alkyl1978/mishen_cxema/README.md

Схемы и прошивки основного блока и ракеток мишени
