alkyl1978/mishen_cxema/сумматор/mishen.jpg

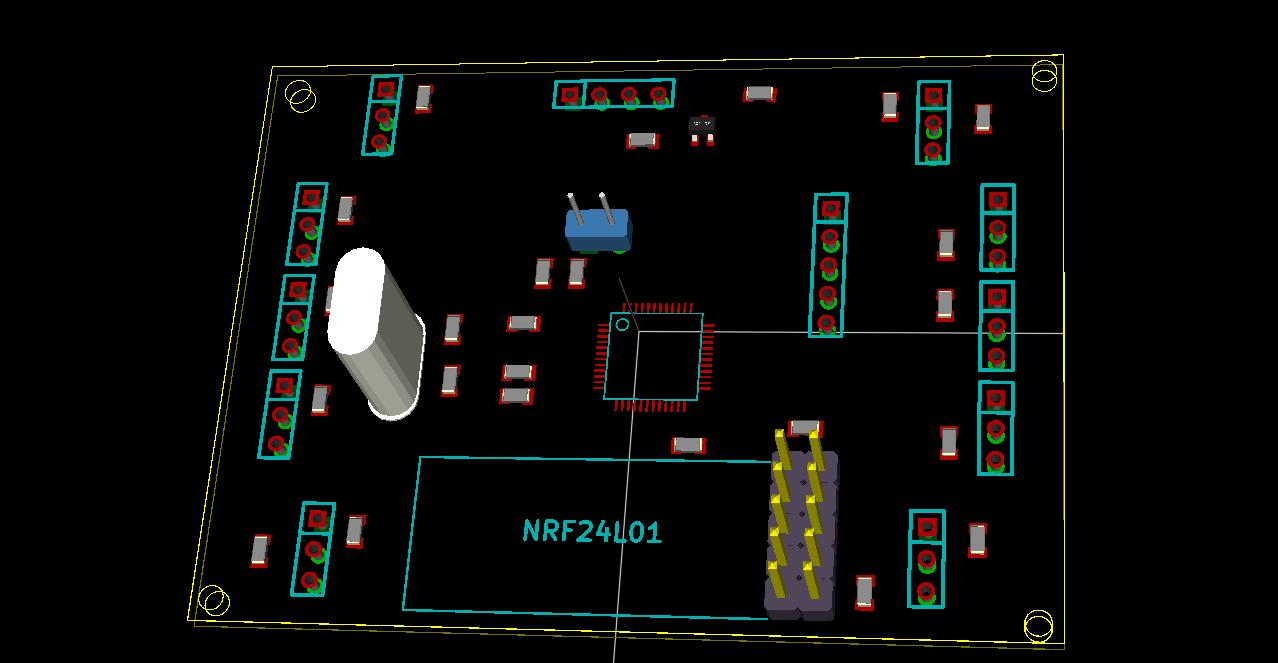
сумматор/mishen.jpg
