alkyl1978/mishen_cxema/(list of files, cad)

Other CAD files:
схемы /Мишень и ракетки ПО/Surnmo_r/Surnmo_r.obj
