alkyl1978/mishen_cxema/схемы /Монитор и клавиатура.pdf

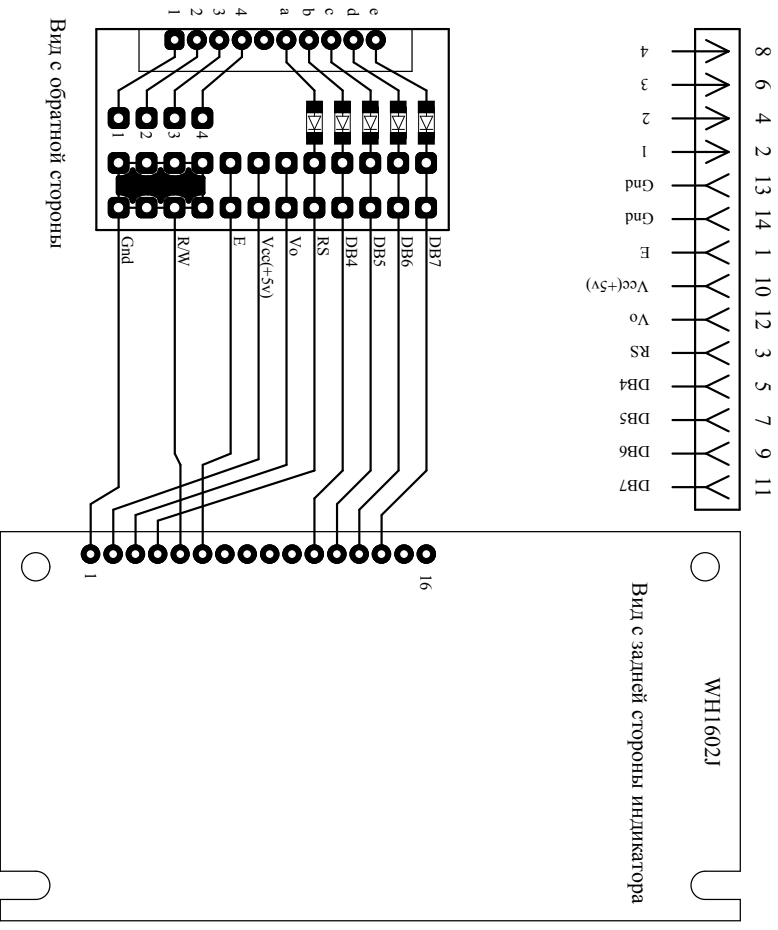
[picture p7: page 1]
Gnd; Vcc(+5v)

Вид с обратной стороны

Вид с задней стороны индикатора
