alkyl1978/mishen_cxema/схемы /Расположение элементов.pdf

SS3

SS2

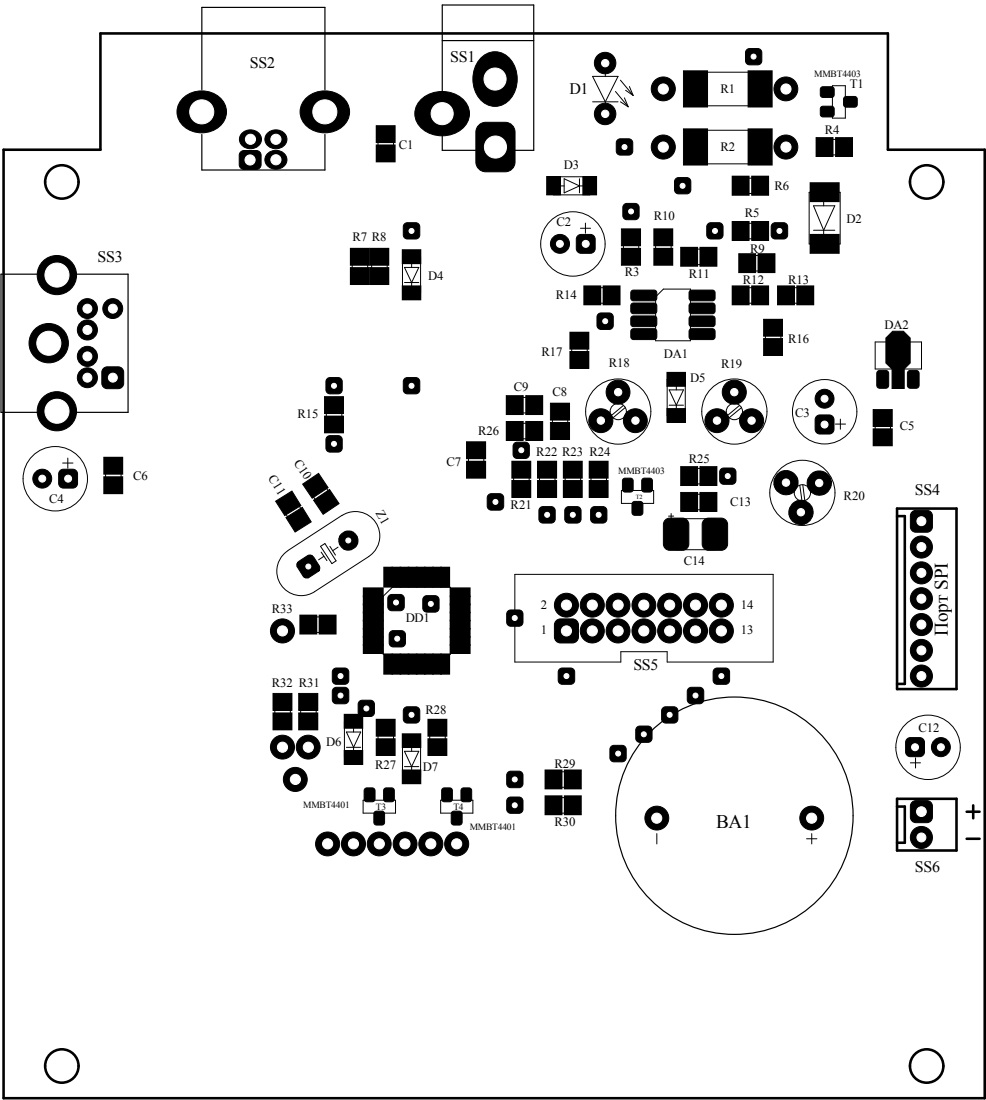
[picture p8: page 1]
