alkyl1978/mishen_cxema/схемы /Схема  инд. и клав.pdf

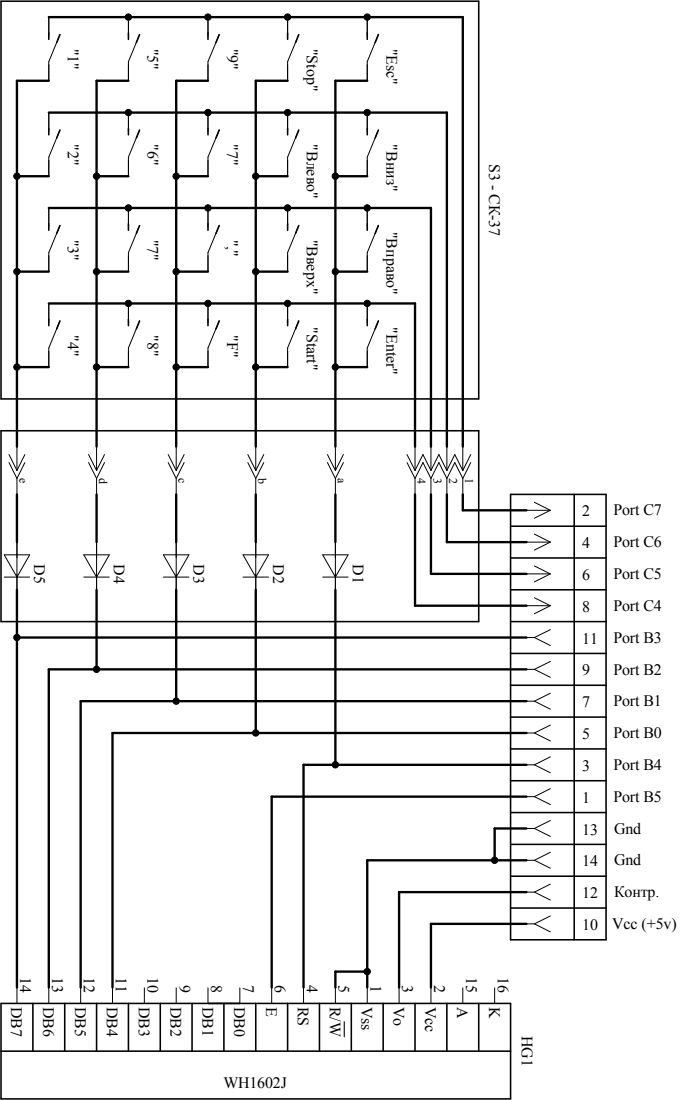
[picture p9: page 1]
