alkyl1978/mishen_cxema/схемы /Схема процессорной платы.pdf

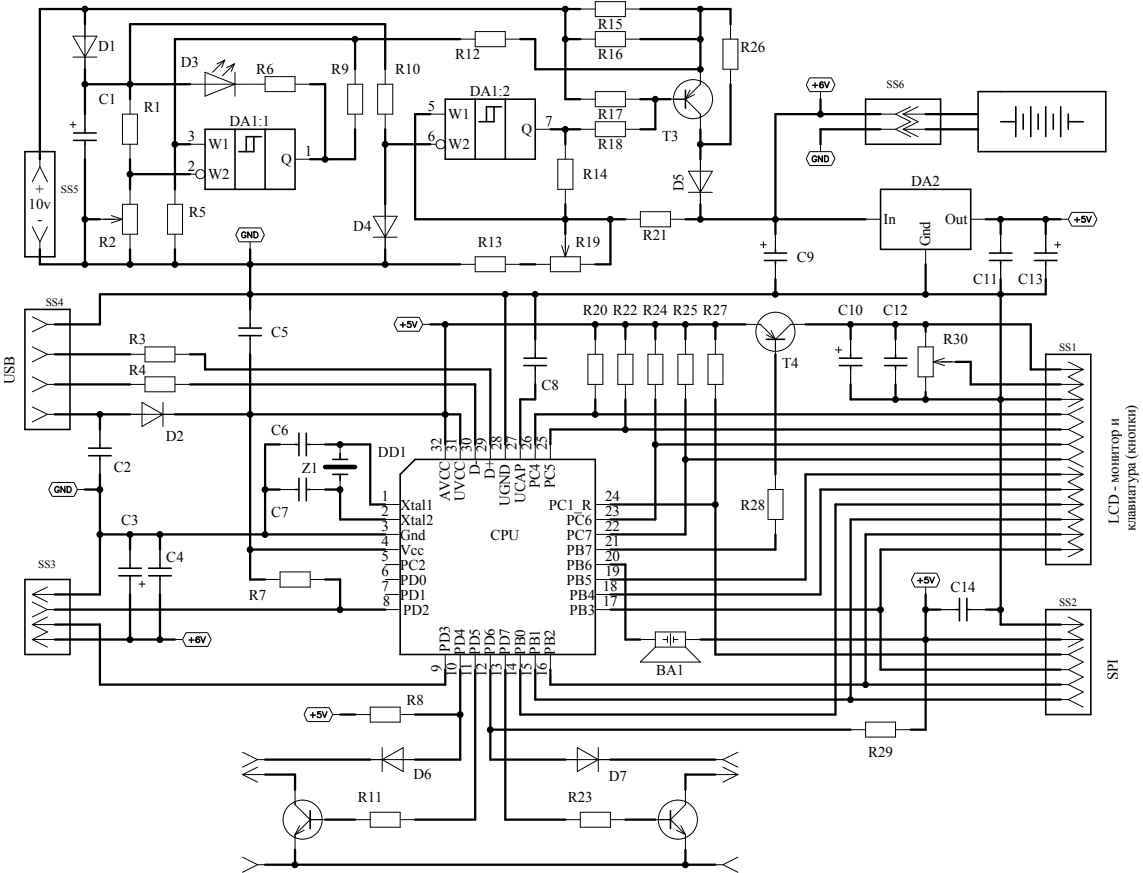
[picture p10: page 1]
