alkyl1978/mishen_cxema/сумматор/mishen.pdf

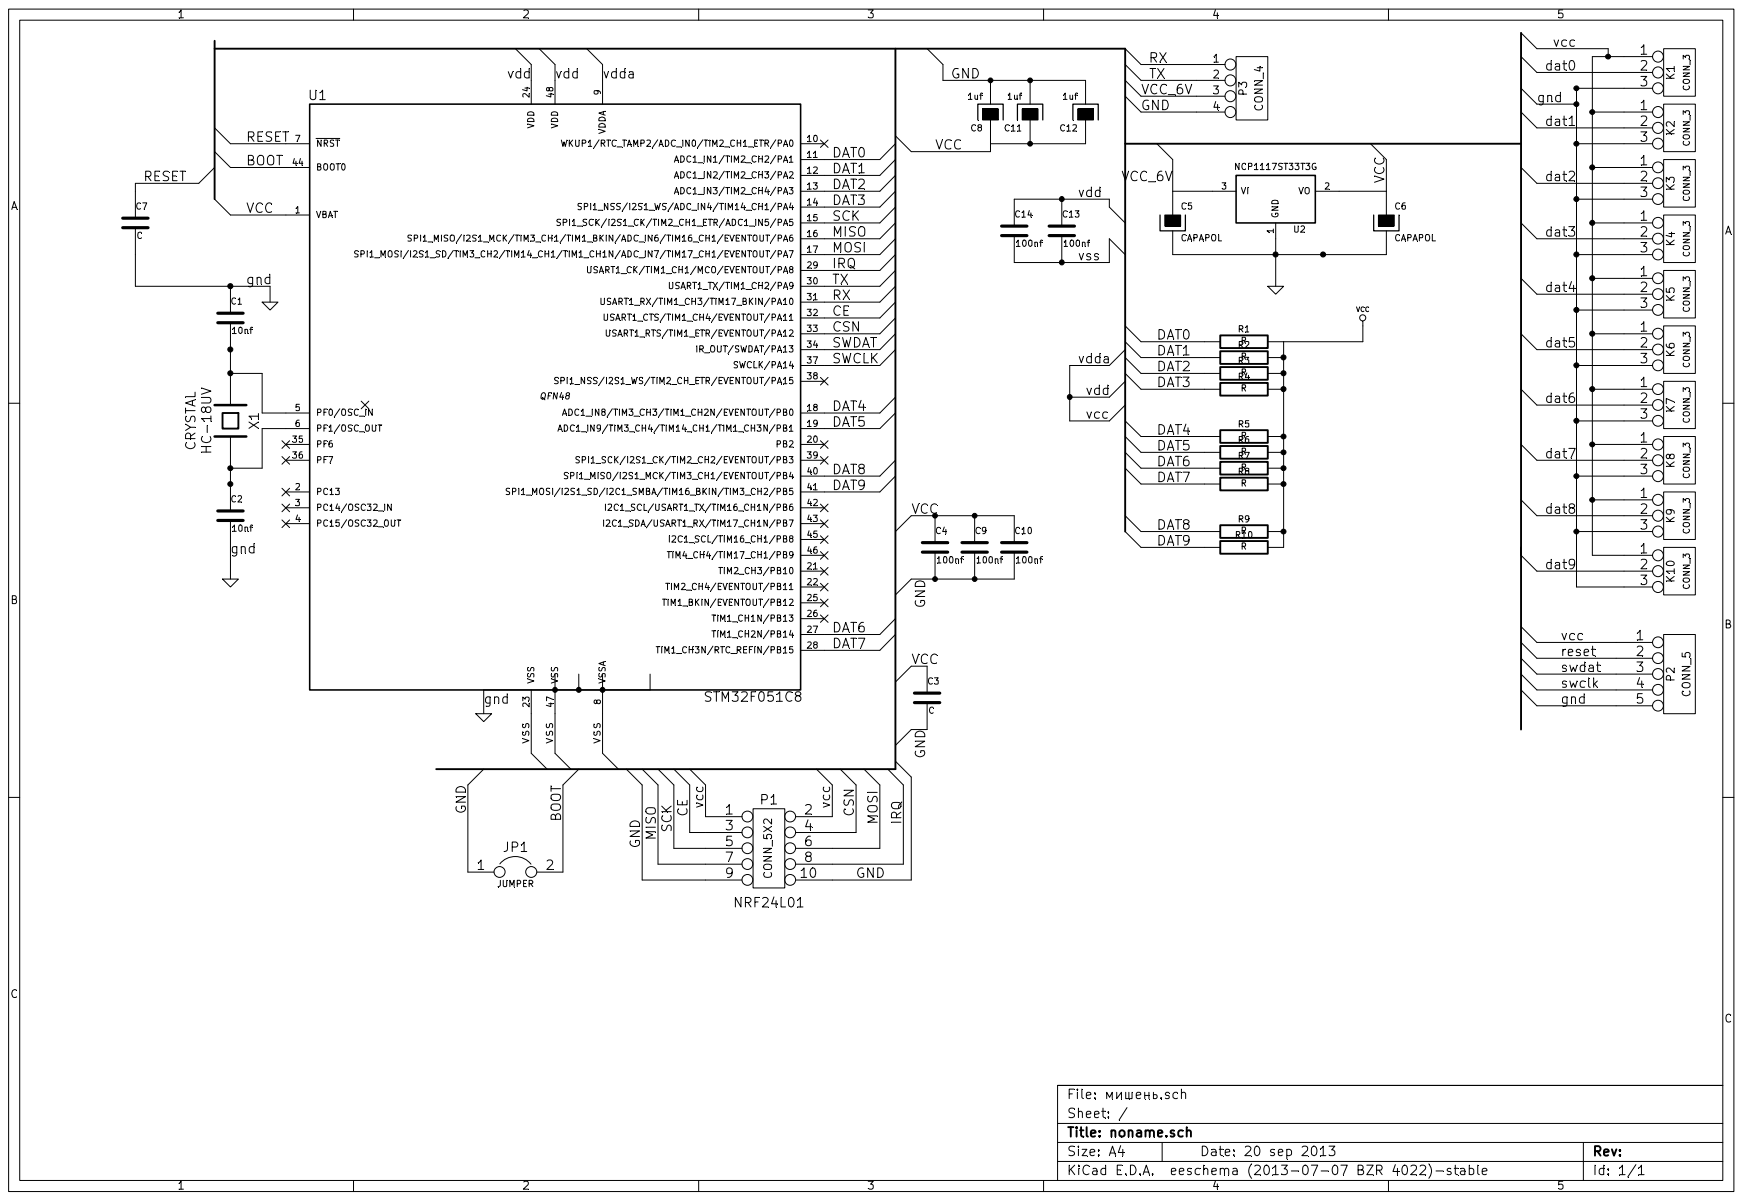
[picture p11: page 1]
