alkyl1978/mishen_cxema/(list of files, drawings)

Other design files:
доработки/cvoe_detektor/detektor.DSN
доработки/cvoe_raketka_a/nrf24l01.DSN
доработки/cvoe_raketka_a/Racket_ATtiny24.PCB
доработки/cvoe_raketka_a/raketka.DSN
доработки/cvoe_raketka_b/nrf24l01.DSN
доработки/cvoe_raketka_b/Racket_ATtiny24.PCB
доработки/cvoe_raketka_b/raketka.DSN
доработки/cvoe_summator/summator.DSN
сумматор/mishen.dsn
схемы /Датчик/Датчик .PCB
схемы /Мишень/Платы/Инд. и клав.PCB
схемы /Мишень/Платы/Плата, инд. и клав.PCB
схемы /Мишень/Платы/Процессорная плата.PCB
схемы /Мишень/Платы/Сумматор.pcb
схемы /Ракетка/Detector_ATtiny2313S.PCB
схемы /Ракетка/Racket_ATtiny24.PCB
