alkyl1978/mishen_cxema/сумматор/mishen.kicad_pcb

## KiCad design сумматор/mishen.kicad_pcb (2015-11-22)

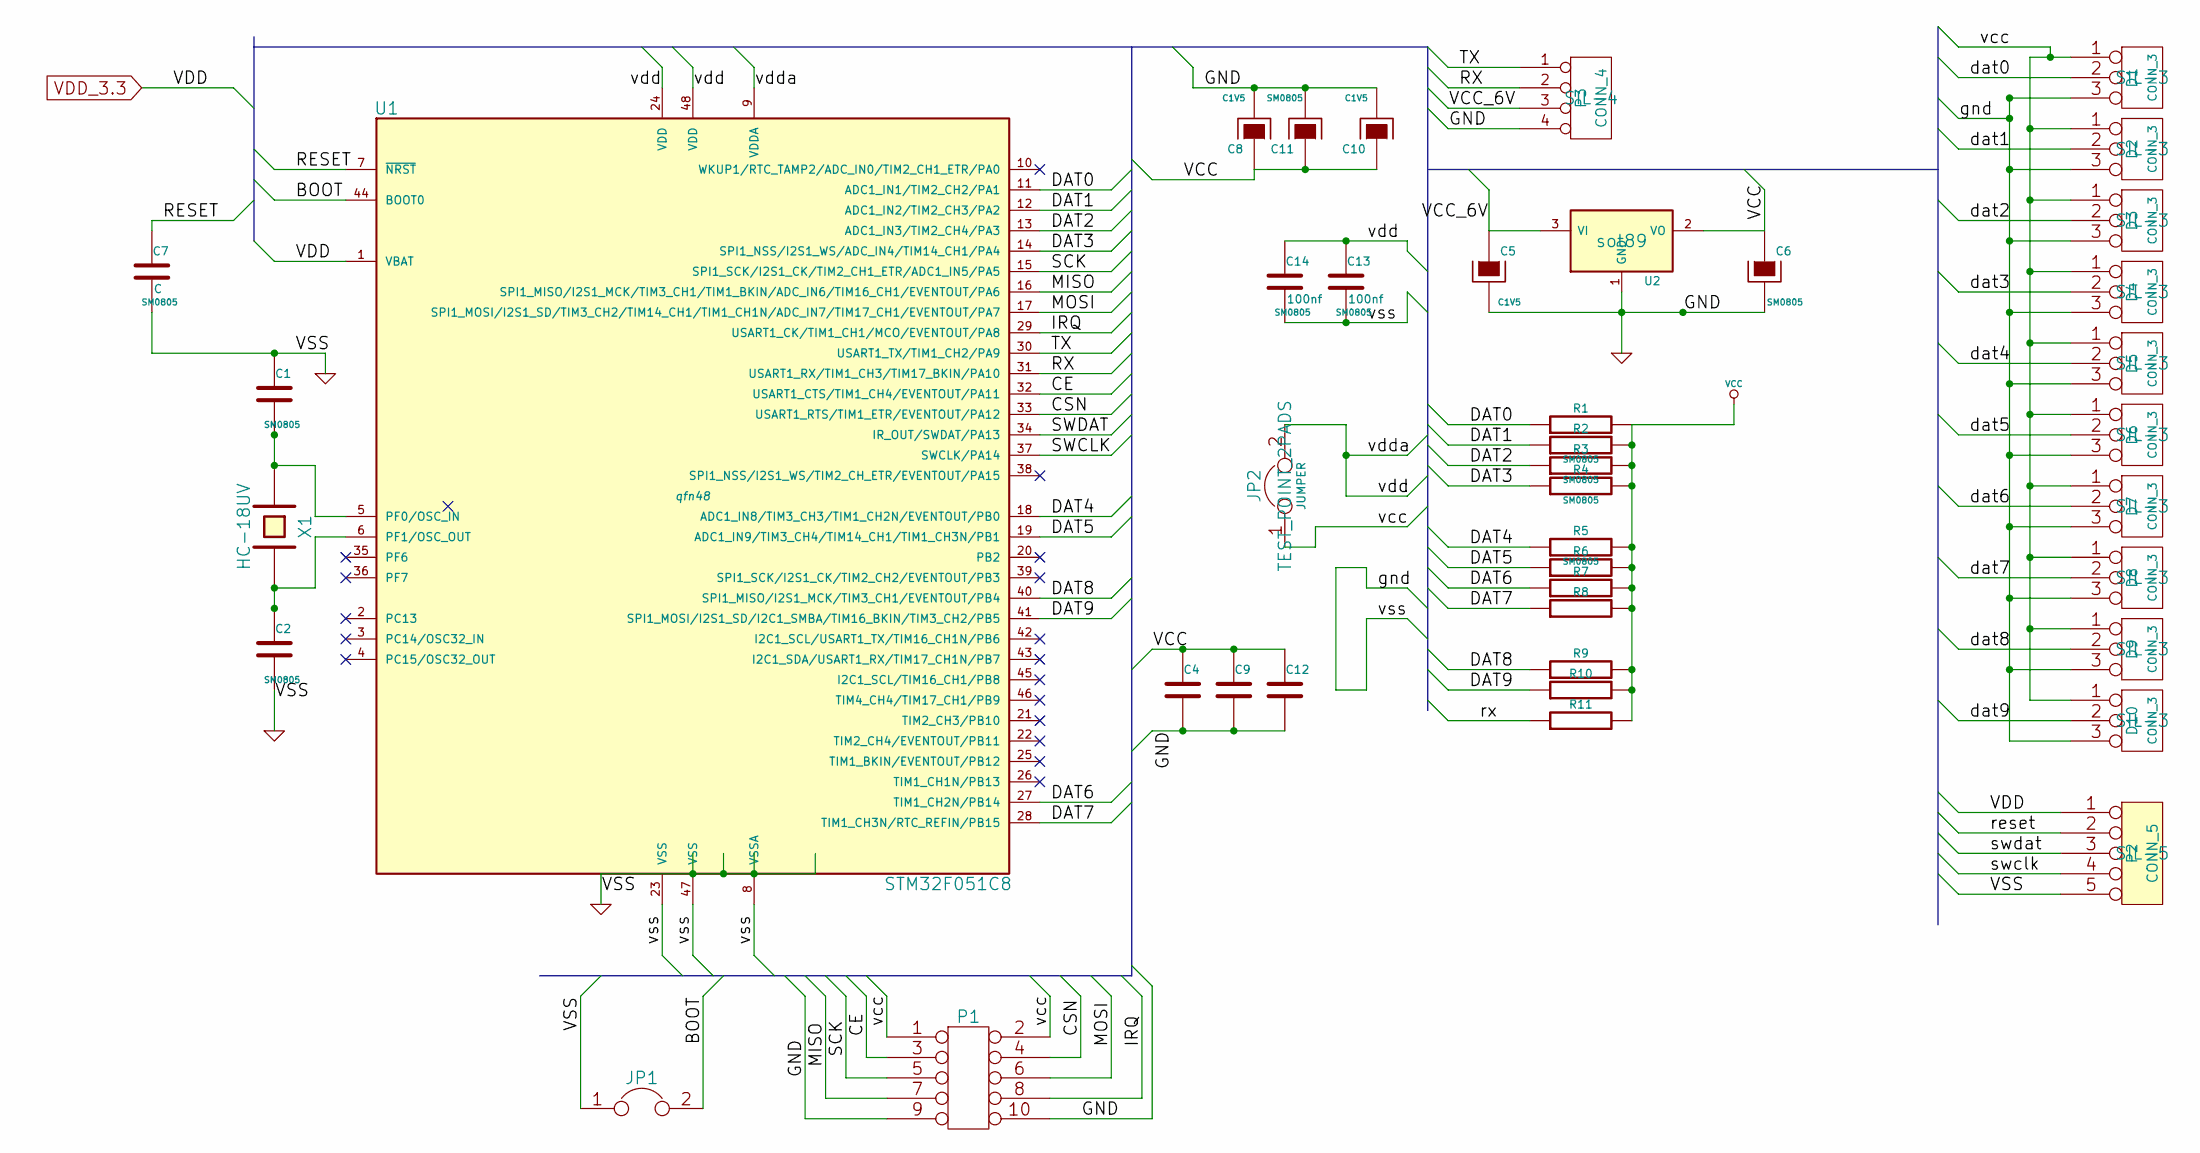
[picture p12: schematic mishen.sch, noname.sch]

Parts:
C1, C2: 10nf; SM0805
C4, C9, C12, C13, C14: 100nf; SM0805
C5: CAPAPOL; C1V5
C6: CAPAPOL; SM0805
C7: C; SM0805
C8, C10: 1uf; C1V5
C11: 1uf; SM0805
D1, D2, D3, D4, D5, D6, D7, D8, D9, D10: CONN_3; SIL-3
JP1, JP2: JUMPER; TEST_POINT_2PADS
P1: CONN_5X2; PIN_ARRAY_5x2
P2: CONN_5; SIL-5
P3: CONN_4; SIL-4
R1: 1KOM; SM0805
R2, R3, R4, R5, R6, R7, R8, R9, R10, R11: R; SM0805
U1: STM32F051С8; qfn48
U2: NCP1117ST33T3G; sot89
X1: 16MGZ; HC-18UV

Connections:
/BOOT: JP1.2, U1.44 (BOOT0)
/CE: P1.3, U1.32 (USART1_CTS/TIM1_CH4/EVENTOUT/PA11)
/CSN: P1.4, U1.33 (USART1_RTS/TIM1_ETR/EVENTOUT/PA12)
/DAT0: D1.2 (PM), R1.1, U1.11 (ADC1_IN1/TIM2_CH2/PA1)
/DAT1: D2.2 (PM), R2.1, U1.12 (ADC1_IN2/TIM2_CH3/PA2)
/DAT2: D3.2 (PM), R3.1, U1.13 (ADC1_IN3/TIM2_CH4/PA3)
/DAT3: D4.2 (PM), R4.1, U1.14 (SPI1_NSS/I2S1_WS/ADC_IN4/TIM14_CH1/PA4)
/DAT4: D5.2 (PM), R5.1, U1.18 (ADC1_IN8/TIM3_CH3/TIM1_CH2N/EVENTOUT/PB0)
/DAT5: D6.2 (PM), R6.1, U1.19 (ADC1_IN9/TIM3_CH4/TIM14_CH1/TIM1_CH3N/P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)
/DAT6: D7.2 (PM), R7.1, U1.27 (TIM1_CH2N/PB14)
/DAT7: D8.2 (PM), R8.1, U1.28 (TIM1_CH3N/RTC_REFIN/PB15)
/DAT8: D9.2 (PM), R9.1, U1.40 (SPI1_MISO/I2S1_MCK/TIM3_CH1/EVENTOUT/PB4)
/DAT9: D10.2 (PM), R10.1, U1.41 (SPI1_MOSI/I2S1_SD/I2C1_SMBA/TIM16_BKIN/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)
/IRQ: P1.8, U1.29 (USART1_CK/TIM1_CH1/MCO/EVENTOUT/PA8)
/MISO: P1.7, U1.16 (SPI1_MISO/I2S1_MCK/TIM3_CH1/TIM1_BKIN/A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)
/MOSI: P1.6, U1.17 (SPI1_MOSI/I2S1_SD/TIM3_CH2/TIM14_CH1/TI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)
/RESET: C7.1, P2.2, U1.7 (~NRST)
/RX: P3.2, R11.1, U1.31 (USART1_RX/TIM1_CH3/TIM17_BKIN/PA10)
/SCK: P1.5, U1.15 (SPI1_SCK/I2S1_CK/TIM2_CH1_ETR/ADC1_IN5/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)
/SWCLK: P2.4, U1.37 (SWCLK/PA14)
/SWDAT: P2.3, U1.34 (IR_OUT/SWDAT/PA13)
/TX: P3.1, U1.30 (USART1_TX/TIM1_CH2/PA9)
/VCC_6V: C5.1, P3.3, U2.3 (VI)
GND: C1.1, C2.2, C4.2, C5.2, C6.2, C7.2, C8.2, C9.2, C10.2, C11.2, C12.2, C13.2, C14.2, D1.3, D2.3, D3.3, D4.3, D5.3, D6.3, D7.3, D8.3, D9.3, D10.3, JP1.1, P1.9, P1.10, P2.5, P3.4, U1.8 (VSSA), U1.23 (VSS), U1.47 (VSS), U2.1 (GND)
unnamed: C2.1, U1.6 (PF1/OSC_OUT), X1.2
unnamed: C1.2, U1.5 (PF0/OSC_IN), X1.1
VCC: C4.1, C6.1, C8.1, C9.1, C10.1, C11.1, C12.1, D1.1, D2.1, D3.1, D4.1, D5.1, D6.1, D7.1, D8.1, D9.1, D10.1, JP2.1, P1.1, P1.2, R1.2, R2.2, R3.2, R4.2, R5.2, R6.2, R7.2, R8.2, R9.2, R10.2, R11.2, U2.2 (VO)
VDD_3.3: C13.1, C14.1, JP2.2, P2.1, U1.1 (VBAT), U1.9 (VDDA), U1.24 (VDD), U1.48 (VDD)

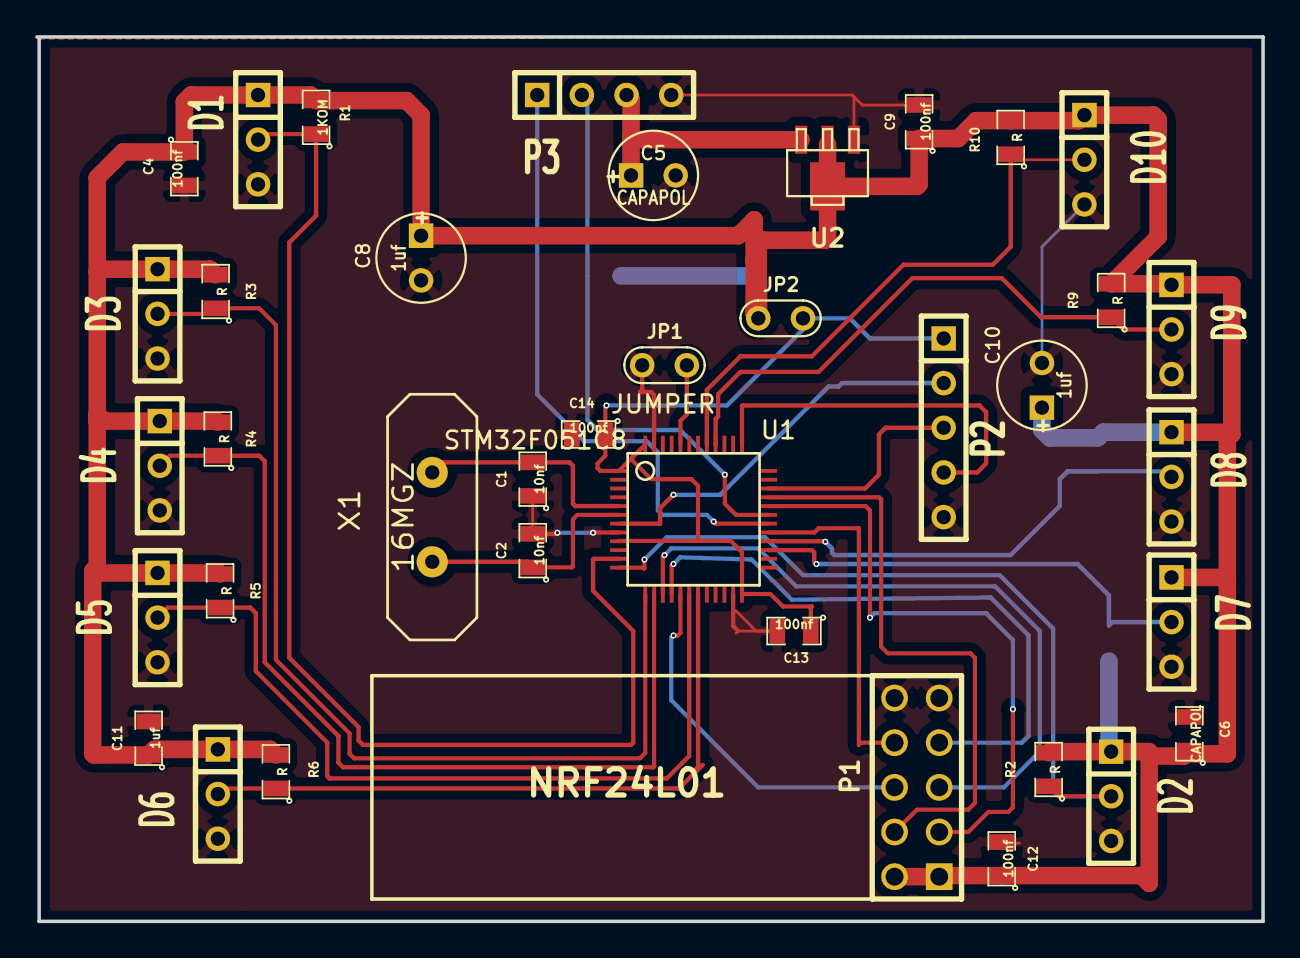
[picture p13: board mishen.kicad_pcb from above]

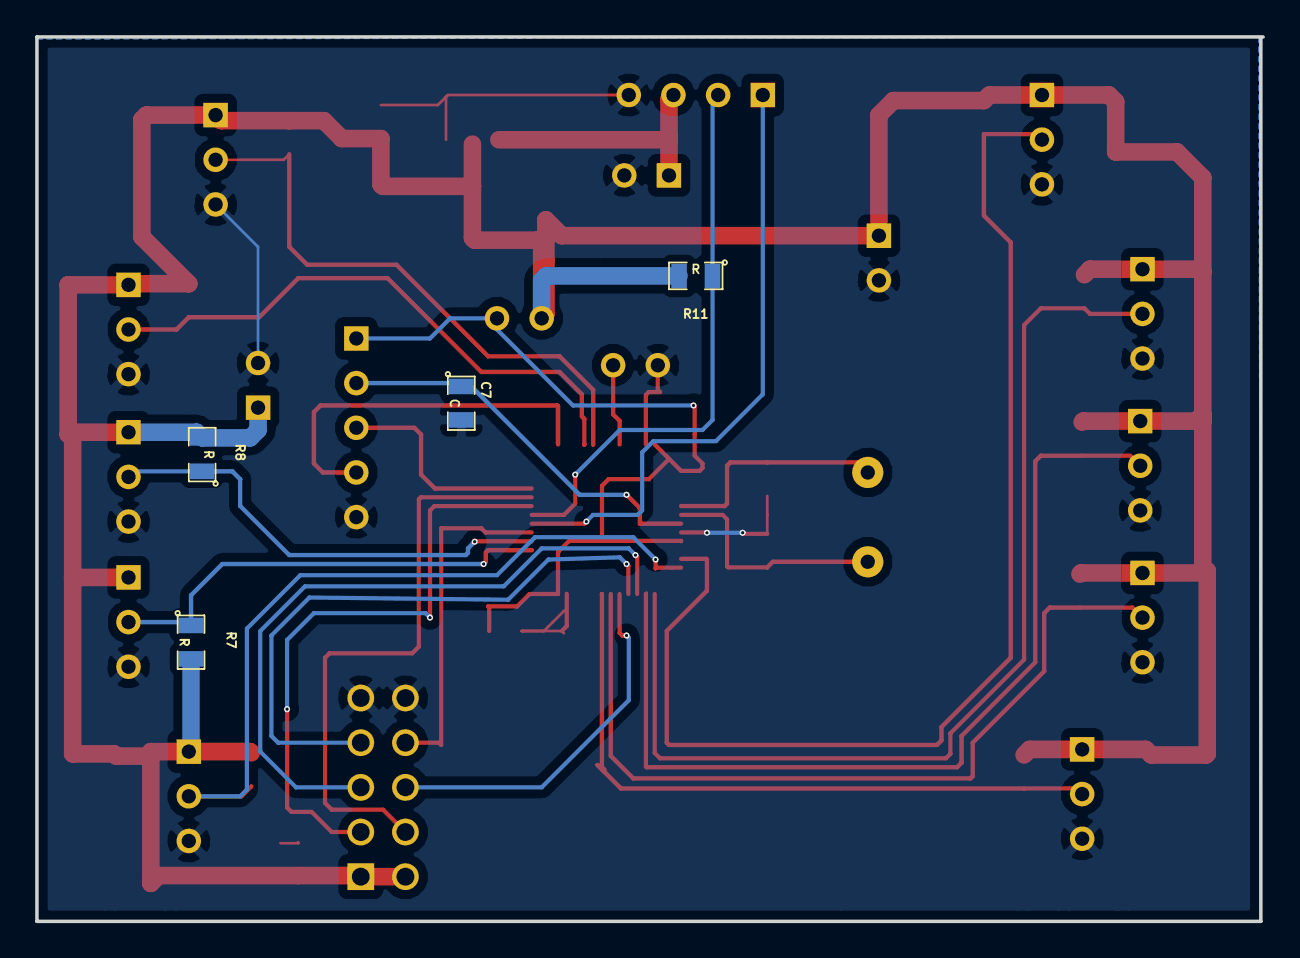
[picture p14: board mishen.kicad_pcb from below]

Board: 2 copper layers, 69.7 x 50.3 mm, 42 parts (4 on the bottom side), 28 nets.
