alkyl1978/mishen_cxema/(commit log)

2015-11-22 first init
    [mishen.csv, mishen.dsn, mishen.kicad_pcb, mishen.sch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]
2016-08-26 разложил по папкам
    [mishen.csv, mishen.dsn, mishen.kicad_pcb, mishen.sch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]
2016-08-26 Добавлены файлы исходное по мишени и прошивки и схемы ракеток и основного блока и документация
    [Detector_ATtiny2313S.PCB, Detector_ATtiny2313S.SCH, Racket_ATtiny24.PCB, Racket_ATtiny24.SCH, Surnmo_r.obj, detektor.DSN, nrf24l01.DSN, raketka.DSN]
